rezack/PRPL2025_ZS/wiki/index.md

---
format:markdown
...

# Josef Tuček, Samuel Stanek - Spectroscopic analysis of spontaneous transport barriers with high time resolution

The introductory presentation can be found [here](<Spectroscopic analysis of spontaneous transport barriers with high time resolution at GOLEM.pdf>).

## Goals

### Motivation

Spontaneous transport barriers have been previously detected at the GOLEM tokamak in helium discharges. A possible cause of spontaneous transport barrier formation is the presence of various impurities such as nitrogen, carbon and metals. [1]

To detect how the composition of select impurities changes before and during the formation of the transport barrier, a spectrometer system with high temporal resolution is needed.

### Previous state

The tokamak already features a fast spectrometer, which is composed of beam splitters, spectral filters and free-space biased detectors. However, this configuration follows only four spectral lines, has poor signal-to-noise ratio and does not detect frequencies above $1\text{ kHz}$.

### Dichroic mirrors

Dichroic mirror is an optical element that reflects light with wavelength smaller than a certain cutoff wavelength and transmits light with higher wavelength. They will be used in the new version of the fast spectrometer to split the incoming radiation towards multiple detectors without losing intensity in the relevant wavelength ranges.

### Plan

In this work, the following tasks are planned:

1. Choose, which wavelengths to study, to better understand transition barriers in GOLEM.
2. Design the spectrometer to measure these wavelengths.
3. Compute the quantum efficiency for radiation hitting each detector.
4. Order the needed part from Thorlabs.
5. Assemble the spectrometer according to the proposed design and attach it to the tokamak.
6. Take measurements of multiple He discharges, where a transport barrier occurs.
7. Analyze the collected data, verify its correctness and compare to other methods of spectrum measurement (fast cameras and slow spectrometers).

### Proposed fast spectrometer configuration

The proposed configuration is illustrated in the figure below. In this setup, 10% of the total radiant intensity is extracted as a reference.
The remaining radiation is subsequently partitioned into specific wavelength regions by means of
dichroic mirrors. Utilizing beam splitters and optical filters, the radiant intensity of individual spectral lines can then be measured. For better reference, code names of used optical parts
are included in the figure.



## Logbook

### Spectral line choice (19.10.2025)

Initially, it was necessary to select specific spectral lines for which the temporal evolution of intensities was to be measured. Based on a comparison of historical helium discharges (shots) on the GOLEM tokamak, the most prominent lines were identified. These lines were selected to align with the research objective of investigating the formation of transport barriers in helium in greater detail. Furthermore, it was essential to select spectral lines sufficiently isolated from neighboring features to prevent spectral overlap and ensure the accuracy of the measured radiant intensity. Following a rigorous analysis, the following spectral lines were selected:

- He I 447.1 nm
- Cl II 479.5 nm
- C II 514.5 nm
- N II 568.6 nm
- He I 587.6 nm
- H<sub>&alpha;</sub> 656.3 nm
- O I 777.0 nm

### Assembled first version with dichroic mirrors (29.10.2025)

A first-generation prototype of the spectroscope was assembled utilizing existing optical components. The spectrometer configuration incorporated filters for the measurement of four specific spectral lines: H<sub>&alpha;</sub>, H<sub>&beta;</sub>, He I 468 nm, and C II 514.5 nm. In order to complete the assembly of the planned spectrometer, the purchase of additional optical elements was required.

### Parts selected for purchase (1.11.2025)

In addition to optical filters, dichroic mirrors, and the supporting infrastructure for the optical components, new [DET100A2](https://www.thorlabs.com/thorproduct.cfm?partnumber=DET100A2) photodiodes from Thorlabs were procured. These are intended to replace the existing detectors to provide a higher output signal. To calculate the bandwidth of these diodes, the following formula was employed [2]:

$$f_{BW} = \frac{1}{2\pi R_{LOAD} \times C_j}$$

$f_{BW}$ is the bandwidth measured in Hz. This represents the maximum frequency at which the photodiode can accurately follow the modulation of the light.
$R_{LOAD}$ stands for the load resistance. It's the resistance of the circuit connected to the photodiode. A larger resistor produces a larger voltage signal but slows down the response time.
$C_j$ is the junction capacitance. This is an internal property of the photodiode.

To achieve the necessary bandwidth and satisfy the Nyquist criterion for measuring phenomena at frequencies up to 50 kHz (while avoiding aliasing), $10\text{ k}\Omega$ resistors were initially selected. However, it was subsequently determined that although these resistors optimized the temporal response of the photodiode, the resulting output signal amplitude was insufficient for reliable detection. Consequently, alternative load resistances of $1\text{ M}\Omega$, $250\text{ k}\Omega$, and $100\text{ k}\Omega$ were evaluated. Ultimately, the $1\text{ M}\Omega$ resistors were selected to provide an adequate signal-to-noise ratio.

### Assembly of full spectroscope (26.11.2025)

> Shots #50581 - #50917

<p align="center">
  Resized Diagram
</p>

The spectroscope was assembled and prepared for future testing. All resistors had value of $1\text{ M}\Omega$ (except the shots mentioned in the following section) and the detectors were connected to the osciloscope according to the following table

| Channel | Spectral Line | Wavelength |
| --- | --- | --- |
| ch1 | He I | 447.1 nm |
| ch2 | O I | 777.0 nm |
| ch3 | N II | 568.6 nm |
| ch4 | C II | 514.5 nm |
| ch5 | Cl II | 479.5 nm |
| ch6 | Whole | - |
| ch7 | He I | 588.0 nm |
| ch8 | Hα | 656.3 nm |

### Scan of multiple resistor values (3.12.2025)

As already mentioned, the tests to determine the ideal load resistance were carried out. The test shots are listed below.

- #50737: $1\text{ M}\Omega$
- #50738: $250\text{ k}\Omega$
- #50739: $100\text{ k}\Omega$
- #50740: $10\text{ k}\Omega$
- #50741: $1\text{ M}\Omega$

### Reconfigure for H discharges (10.12.2025 and 16.12.2025)

> Shots #50917 - present (at least until 12.1.2026)

The initial optical configuration underwent minor modifications to optimize detection during hydrogen (H) discharges. An aperture stop was integrated into the system to further refine the beam geometry. The current layout, representing the most recent iteration as of January 4, 2026, is illustrated in the figure below.

Note: The annotations above and below the filter designations indicate the specific oscilloscope channel to which the corresponding photodiode is interfaced.

The modified connections to the osciloscopes are listed in the table below:

| Channel | Spectral Line | Wavelength |
| --- | --- | --- |
| ch1 | He I | 447.1 nm |
| ch2 | O I | 777.0 nm |
| ch3 | N II | 568.6 nm |
| ch4 | C II | 514.5 nm |
| ch5 | Hβ | 486.1 nm |
| ch6 | Whole | - |
| ch7 | Hγ | 434.0 nm |
| ch8 | Hα | 656.3 nm |

Additionally, the resistors for the "whole" and Hα detectors have been changed to $100\text{ k}\Omega$.

### Applied load resistor values as of 1.5.2026

| Channel | Spectral Line | Resistance |
| --- | --- | --- |
| ch1 | He I | 1 MΩ |
| ch2 | O I | 1 MΩ |
| ch3 | N II | 1 MΩ |
| ch4 | C II | 1 MΩ |
| ch5 | Hβ | 1 MΩ |
| ch6 | Whole | 250 kΩ |
| ch7 | Hγ | 1 MΩ |
| ch8 | Hα | 250 kΩ |

### Bandwidth increase attempt with the AIM-TTi WA301 amplifier (4.5.2026)

Instead of a load resistor, the output of the Hα photodiode has been connected directly to the AIM-TTi WA301 voltage amplifier. This amplifier has an input impedance of 10 kΩ and a gain of 10, resulting in a total bandwidth of 100 kHz and amplification of 100 kV/A. This configuration has been tested during shot #52366. Next, the NI 9222 DAW has been temporarily replaced with the Tektronik MSO64 oscilloscope, with 16-bit resolution and 600 MS/s sampling rate, mainly due to the increase D/A conversion resolution. However, this measurement has been unsuccessfull.

### Assembly and testing of a OPA197-based transimpedance amplyfier circuit (27.5.2026)

A new transimpedance amplyfier circuit has been designed with a gain of $10^6 \text{V/A}$ and a bandwidth of 100 kHz. The schema is displayed below.
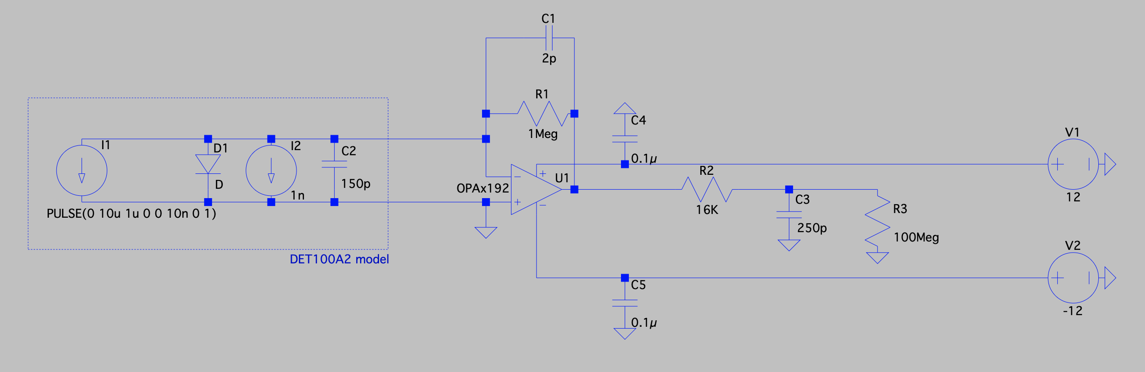
[picture p1: wiki/OPA197-TA.png]
Circuit schema of an OP197-based transimpedance amplyfier


A signal generator set to 100 mV with a 1 MΩ series ressistor has been used as a current source to test step response and noise floor. The results of the step response test and FODP fit are below.

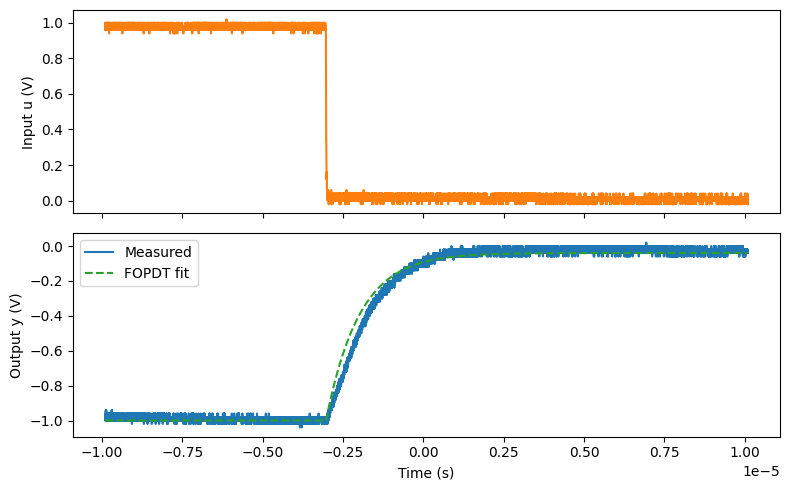
[picture p2: wiki/og_amp_step.png]
Plot of step input and system response

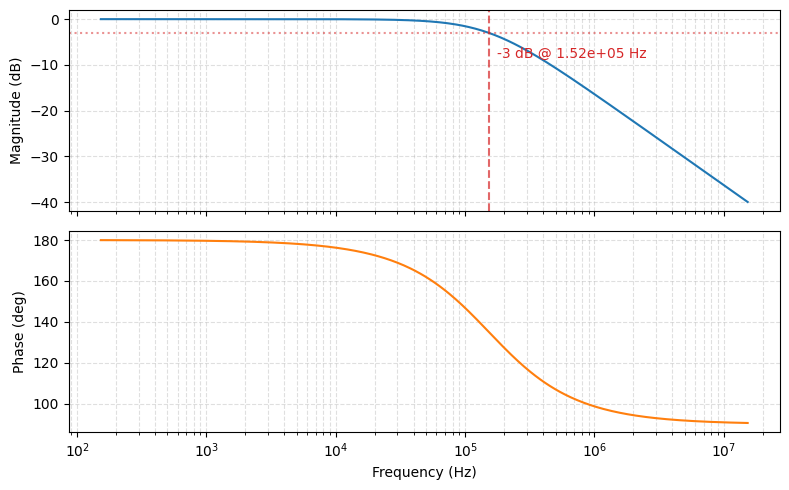
[picture p3: wiki/og_amp_bode.png]
Plot of FODP fit


### Further testing of the transimpedance amplyfier circuit (28.5.2026)

The threshold frequency of the amplyfier has been determined to be **150 kHz** from a bode plot measured by Rigol MSO5074. The current source has been modeled by a 1MΩ resistor on the input to the TIA and 1V input voltage.

The TIA has been installed at the output of the broad spectrum photodiode and tested on the shot #52880. The measured waveform can be found on ch8 (not ch6) of the fast spectroscope DAQ.

### Faraday cage installation and noise density measurement (29.5.2026)

The spectroscope has been placed inside a metal enclosure to shield it from RF interference and its noise voltage density has been tested with floating input and determined to be 10 000 $\mu \textrm{V} / \sqrt{\textrm{Hz}}$, which is about tho orders of magnitude more than it should be.

During the attempt to find the source of the noise, the TIA blew up :(

## Concluding report

The final presentation is available [here](<New fast spectroscopy diagnostic at GOLEM - results.pdf>).

## What to do in the future? (for future students)

1. Increase signal intensity / decrease interference
2. Increase the detection sensitivity (e.g. using Photomultiplier tubes)
3. ~Restrict the field of view~ - this has been shown to decrease intensity too much (Štěpán Hladík)
4. We could just get rid of the splitters, doubling the sensitivity
5. Compare measurements from fast cameras, slow spectrometers and fast spectrometer ✅ (Štěpán Hladík)
6. Assemble fast spectrometer fo He plasmas ✅ (Štěpán Hladík)
7. Explore why Whole and He line doesn't agreee with slow spectrometer
8. Get the response of the fast spectrometer as a Green function
9. Use optic cables for transfer of digitized data

## Bibliography

[1] P. Macha et al., “Spontaneous formation of a transport barrier in helium plasma in a tokamak with circular configuration,” Nucl. Fusion, vol. 63, no. 10, p. 104003, Oct. 2023, doi: 10.1088/1741-4326/acf1af.

[2] Thorlabs, Inc., "Photodiode Tutorial," Thorlabs.com. [Online]. Available: https://www.thorlabs.com/free-space-biased-detectors?tabName=Photodiode%2520Tutorial
