rezack/PRPL2025_ZS/DET100A_amp_5V/DET100A_amp_5V-rezac.kicad_pcb

## KiCad design DET100A_amp_5V/DET100A_amp_5V-rezac.kicad_pcb (2026-06-18)

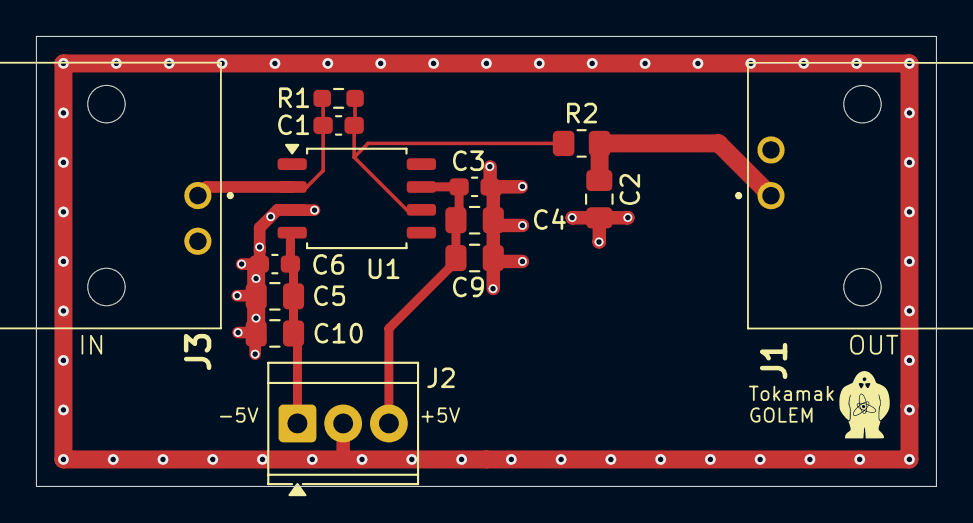
[picture p4: board DET100A_amp_5V-rezac.kicad_pcb from above]

Board: 2 copper layers, 50.0 x 25.0 mm, 14 parts (0 on the bottom side), 6 nets.

Parts:
C1: 1p; C_0603_1608Metric_Pad1.08x0.95mm_HandSolder
C2: 30n; C_0805_2012Metric_Pad1.18x1.45mm_HandSolder
C3, C6: 1n; C_0603_1608Metric_Pad1.08x0.95mm_HandSolder
C4, C5: 100n; C_0805_2012Metric_Pad1.18x1.45mm_HandSolder
C9, C10: 10u; C_0805_2012Metric_Pad1.18x1.45mm_HandSolder
J1, J3: 5227677-1; 52276771
J2: Screw_Terminal_01x03; TerminalBlock_TE_282834-3_1x03_P2.54mm_Horizontal
R1: 2M; R_0603_1608Metric_Pad0.98x0.95mm_HandSolder
R2: 50; R_0805_2012Metric_Pad1.20x1.40mm_HandSolder
U1: OPA656NB/250; SOIC-8_5.3x5.3mm_P1.27mm

Connections:
GND: C2.1, C3.1, C4.1, C5.1, C6.1, C9.2, C10.1, J1.2 (Ext), J2.2, J3.2 (Ext), U1.3 (NONIINVERTINGINPUT)
unnamed: C2.2, J1.1 (In), R2.2
unnamed: C3.2, C4.2, C9.1, J2.3 (Pin_1), U1.7 (VS+)
unnamed: C5.2, C6.2, C10.2, J2.1 (Pin_3), U1.4 (VS-)
unnamed: C1.1, J3.1 (In), R1.1, U1.2 (INVERTINGINPUT)
unnamed: C1.2, R1.2, R2.1, U1.6 (OUTPUT)
