rezack/PRPL2025_ZS/(commit log)

2026-06-12 feat: add some silkscreen elements
    [DET100A_amp_5V.kicad_pcb]
2026-06-18 konzultace 18.6.2026, board, 3D print settings
    [DET100A_amp_5V-rezac.kicad_pcb]
